PortmanteauDevices/Pianocade/board/Pianocade.sch

## KiCad design board/Pianocade.sch (2012-12-21)

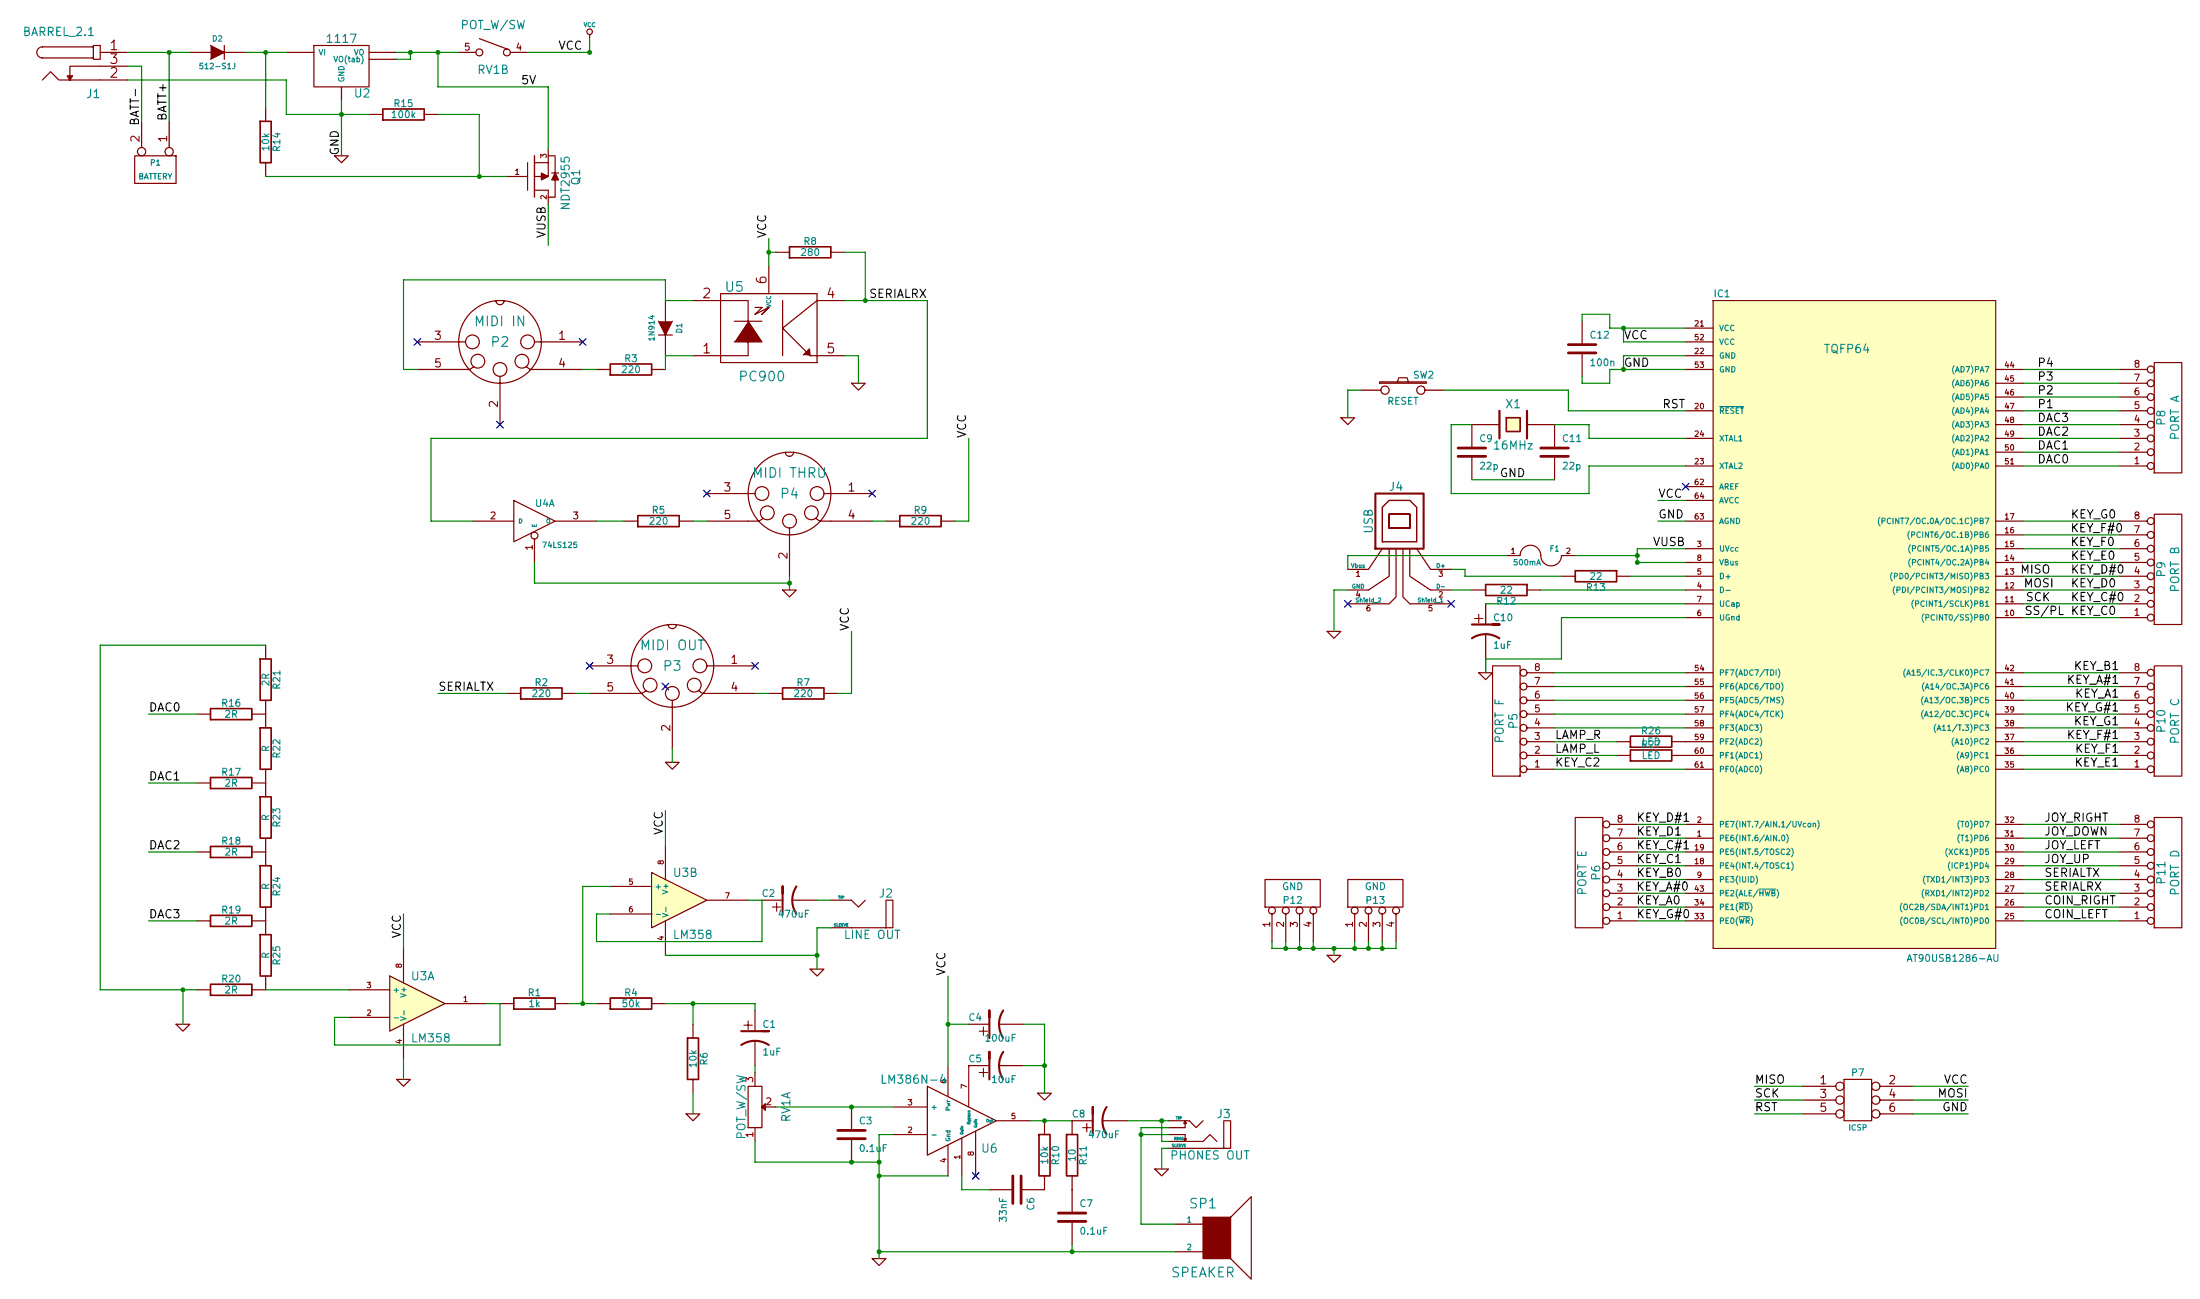
[picture p9: schematic Pianocade.sch]

Parts:
C1, C10: 1uF
C2, C8: 470uF
C3, C7: 0.1uF
C4: 100uF
C5: 10uF
C6: 33nF
C9, C11: 22p
C12: 100n
D1: 1N914
D2: 512-S1J
F1: 500mA; 1210; Part number MF-USMF050-2
IC1: AT90USB1286-AU; TQFP64
J1: BARREL_2.1
J2: LINE OUT
J3: PHONES OUT
J4: USB
P1: BATTERY
P2: MIDI IN
P3: MIDI OUT
P4: MIDI THRU
P5: PORT F
P6: PORT E
P7: ICSP
P8: PORT A
P9: PORT B
P10: PORT C
P11: PORT D
P12, P13: GND
Q1: NDT2955
R1: 1k
R2, R3, R5, R7, R9: 220
R4: 50k
R6, R10, R14: 10k
R8: 280
R11: 10
R12, R13: 22
R15: 100k
R16, R17, R18, R19, R20, R21: 2R
R22, R23, R24, R25: R
R26, R27: LED
RV1: POT_W/SW
SP1: SPEAKER
SW2: RESET
U2: 1117
U3: LM358
U4: 74LS125
U5: PC900
U6: LM386N-4
X1: 16MHz

Connections:
5V: Q1.3 (S), RV1.5, U2.2 (VO), U2.4 (VO(tab))
BATT+: D2.1 (A), J1.1 (CENTRE), P1.1
BATT-: J1.3 (SW), P1.2 (PM)
COIN_LEFT: IC1.25 ((OC0B/SCL/INT0)PD0), P11.1
COIN_RIGHT: IC1.26 ((OC2B/SDA/INT1)PD1), P11.2
DAC0: IC1.51 ((AD0)PA0), P8.1, R16.1
DAC1: IC1.50 ((AD1)PA1), P8.2, R17.1
DAC2: IC1.49 ((AD2)PA2), P8.3, R18.1
DAC3: IC1.48 ((AD3)PA3), P8.4, R19.1
GND: C3.2, C4.2, C5.2, C7.2, C9.2, C10.2, C11.2, C12.2, IC1.6 (UGnd), IC1.22 (GND), IC1.53 (GND), IC1.63 (AGND), J1.2, J2.1 (SLEEVE), J3.1 (SLEEVE), J4.4 (GND), P3.2, P4.2, P7.6, P12.1, P12.2, P12.3, P12.4, P13.1, P13.2, P13.3, P13.4, R6.2, R15.1, R20.1, R21.1, RV1.1, SP1.2, SW2.1, U2.1 (GND), U3.4 (V-), U4.1 (E), U5.5, U6.2 (-), U6.4 (Gnd)
JOY_DOWN: IC1.31 ((T1)PD6), P11.7
JOY_LEFT: IC1.30 ((XCK1)PD5), P11.6
JOY_RIGHT: IC1.32 ((T0)PD7), P11.8
JOY_UP: IC1.29 ((ICP1)PD4), P11.5
KEY_A0: IC1.34 (PE1(~RD~)), P6.2
KEY_A1: IC1.40 ((A13/OC.3B)PC5), P10.6
KEY_A#1: IC1.41 ((A14/OC.3A)PC6), P10.7
KEY_B0: IC1.9 (PE3(IUID)), P6.4
KEY_B1: IC1.42 ((A15/IC.3/CLK0)PC7), P10.8
KEY_C0: IC1.10 ((PCINT0/SS)PB0), P9.1
KEY_C1: IC1.18 (PE4(INT.4/TOSC1)), P6.5
KEY_C2: IC1.61 (PF0(ADC0)), P5.1
KEY_D0: IC1.12 ((PDI/PCINT3/MOSI)PB2), P7.4, P9.3
KEY_D1: IC1.1 (PE6(INT.6/AIN.0)), P6.7
KEY_E0: IC1.14 ((PCINT4/OC.2A)PB4), P9.5
KEY_E1: IC1.35 ((A8)PC0), P10.1
KEY_F0: IC1.15 ((PCINT5/OC.1A)PB5), P9.6
KEY_F1: IC1.36 ((A9)PC1), P10.2
KEY_F#1: IC1.37 ((A10)PC2), P10.3
KEY_G0: IC1.17 ((PCINT7/OC.0A/OC.1C)PB7), P9.8
KEY_G1: IC1.38 ((A11/T.3)PC3), P10.4
KEY_G#1: IC1.39 ((A12/OC.3C)PC4), P10.5
LAMP_L: P5.2, R27.1
LAMP_R: P5.3, R26.1
MISO: IC1.13 ((PD0/PCINT3/MISO)PB3), P7.1, P9.4
unnamed: C1.1, R4.2, R6.1
unnamed: C1.2, RV1.3
unnamed: C2.1, U3.6 (-), U3.7
unnamed: C2.2, J2.3 (TIP)
unnamed: C3.1, RV1.2, U6.3 (+)
unnamed: C5.1, U6.7 (Bypass)
unnamed: C6.1, R10.2
unnamed: C6.2, U6.1 (Gain)
unnamed: C7.1, R11.2
unnamed: C8.1, R10.1, R11.1, U6.5 (Out)
unnamed: C8.2, J3.2 (RING), J3.3 (TIP)
unnamed: C9.1, IC1.23 (XTAL2), X1.1
unnamed: C10.1, IC1.7 (UCap)
unnamed: C11.1, IC1.24 (XTAL1), X1.2
unnamed: D1.1 (A), P2.5, U5.2
unnamed: D1.2 (K), R3.2, U5.1
unnamed: D2.2 (K), R14.1, U2.3 (VI)
unnamed: F1.1, J4.1 (Vbus)
unnamed: IC1.2 (PE7(INT.7/AIN.1/UVcon)), P6.8
unnamed: IC1.4 (D-), R12.1
unnamed: IC1.5 (D+), R13.1
unnamed: IC1.16 ((PCINT6/OC.1B)PB6), P9.7
unnamed: IC1.19 (PE5(INT.5/TOSC2)), P6.6
unnamed: IC1.33 (PE0(~WR~)), P6.1
unnamed: IC1.43 (PE2(ALE/~HWB~)), P6.3
unnamed: IC1.54 (PF7(ADC7/TDI)), P5.8
unnamed: IC1.55 (PF6(ADC6/TDO)), P5.7
unnamed: IC1.56 (PF5(ADC5/TMS)), P5.6
unnamed: IC1.57 (PF4(ADC4/TCK)), P5.5
unnamed: IC1.58 (PF3(ADC3)), P5.4
unnamed: IC1.59 (PF2(ADC2)), R26.2
unnamed: IC1.60 (PF1(ADC1)), R27.2
unnamed: J3.5, J3.6, SP1.1
unnamed: J4.2 (D-), R12.2
unnamed: J4.3 (D+), R13.2
unnamed: P2.4, R3.1
unnamed: P3.4, R7.1
unnamed: P3.5, R2.2
unnamed: P4.4, R9.1
unnamed: P4.5, R5.2
unnamed: Q1.1 (G), R14.2, R15.2
unnamed: R1.1, U3.1, U3.2 (-)
unnamed: R1.2, R4.1, U3.5 (+)
unnamed: R5.1, U4.3 (O)
unnamed: R16.2, R21.2, R22.1
unnamed: R17.2, R22.2, R23.1
unnamed: R18.2, R23.2, R24.1
unnamed: R19.2, R24.2, R25.1
unnamed: R20.2, R25.2, U3.3 (+)
P1: IC1.47 ((AD4)PA4), P8.5
P2: IC1.46 ((AD5)PA5), P8.6
P3: IC1.45 ((AD6)PA6), P8.7
P4: IC1.44 ((AD7)PA7), P8.8
RST: IC1.20 (~RESET), P7.5, SW2.2
SCK: IC1.11 ((PCINT1/SCLK)PB1), P7.3, P9.2
SERIALRX: IC1.27 ((RXD1/INT2)PD2), P11.3, R8.2, U4.2 (D), U5.4
SERIALTX: IC1.28 ((TXD1/INT3)PD3), P11.4, R2.1
VCC: C4.1, C12.1, IC1.21 (VCC), IC1.52 (VCC), IC1.64 (AVCC), P7.2, R7.2, R8.1, R9.2, RV1.4, U3.8 (V+), U5.6 (VCC), U6.6 (Pwr)
VUSB: F1.2, IC1.3 (UVcc), IC1.8 (VBus), Q1.2 (D)
