PortmanteauDevices/Pianocade/pianocade_banked.h

  /* BANK 0, 50% square */
#define SQUARE50 {/* 0 */ 0x70, 0, /* 1 */ 0, 0, /* 2 */ 0, 0, /* 3 */ 0, 0, /* 4 */ 0, 0, /* 5 */ 0, 0, /* 6 */ 0, 0, /* 7 */ 0, 0, /* 8 */ 0, 0, /* 9 */ 0, 0, /* A */ 0, 0, /* B */ 0, 0, /* C */ 0, 0, /* D */ 0, 0, /* E */ 0, 0, /* F */ 0x30, 0}
  /* BANK 1, 25% square */
#define SQUARE25 {/* 0 */ 0x70, 0, /* 1 */ 0, 0, /* 2 */ 0, 0, /* 3 */ 0, 0, /* 4 */ 0, 0, /* 5 */ 0, 0, /* 6 */ 0, 0, /* 7 */ 0, 0, /* 8 */ 0, 0, /* 9 */ 0, 0, /* A */ 0, 0, /* B */ 0, 0, /* C */ 0, 0, /* D */ 0, 0, /* E */ 0, 0, /* F */ 0x30, 0}
  /* BANK 2, "Violin" */
#define VIOLIN {/* 0 */ 0x11, 0x03, /* 1 */ 0x70, 0, /* 2 */ 0x21, 0x03, /* 3 */ 0x72, 0, /* 4 */ 0, 0, /* 5 */ 0, 0, /* 6 */ 0, 0, /* 7 */ 0, 0, /* 8 */ 0, 0, /* 9 */ 0, 0, /* A */ 0, 0, /* B */ 0, 0, /* C */ 0, 0, /* D */ 0, 0, /* E */ 0, 0, /* F */ 0x30, 0}  
  /* BANK 3, 12.5% square */
#define SQUARE12{/* 0 */ 0x70, 0, /* 1 */ 0, 0, /* 2 */ 0, 0, /* 3 */ 0, 0, /* 4 */ 0, 0, /* 5 */ 0, 0, /* 6 */ 0, 0, /* 7 */ 0, 0, /* 8 */ 0, 0, /* 9 */ 0, 0, /* A */ 0, 0, /* B */ 0, 0, /* C */ 0, 0, /* D */ 0, 0, /* E */ 0, 0, /* F */ 0x30, 0}
  /* BANK 4, "Piano" */
#define PIANO{/* 0 */ 0x11, 0, /* 1 */ 0x70, 6, /* 2 */ 0x21, 0x02, /* 3 */ 0x72, 7, /* 4 */ 0x21, 0x0F, /* 5 */ 0x0F, 0x0F, /* 6 */ 0x74, 4, /* 7 */ 0, 0, /* 8 */ 0x77, 0, /* 9 */ 0, 0, /* A */ 0, 0, /* B */ 0, 0, /* C */ 0, 0, /* D */ 0, 0, /* E */ 0x21, 0, /* F */ 0x7E, 0}
 /* BANK 5, Tremolo (fast) */
#define TREMOLO_FAST{/* 0 */ 0x22, 0, /* 1 */ 0x70, 2, /* 2 */ 0x12, 0, /* 3 */ 0x72, 2, /* 4 */ 0x70, 0, /* 5 */ 0, 0, /* 6 */ 0, 0, /* 7 */ 0, 0, /* 8 */ 0, 0, /* 9 */ 0, 0, /* A */ 0, 0, /* B */ 0, 0, /* C */ 0, 0, /* D */ 0, 0, /* E */ 0, 0, /* F */ 0x30, 0}
 /* BANK 6, Mario coin (on release) */
#define COIN_RELEASE{/* 0 */ 0x70, 0, /* 1 */ 0x5C, 0, /* 2 */ 0x21, 0x02, /* 3 */ 0x72, 0, /* 4 */ 0, 0, /* 5 */ 0, 0, /* 6 */ 0, 0, /* 7 */ 0, 0, /* 8 */ 0, 0, /* 9 */ 0, 0, /* A */ 0, 0, /* B */ 0, 0, /* C */ 0, 0, /* D */ 0, 0, /* E */ 0, 0, /* F */ 0x30, 0}
  /* BANK 7, Game Boy envelope */
#define GB {/* 0 */ 0x21, 0x01, /* 1 */ 0x70, 0, /* 2 */ 0, 0, /* 3 */ 0, 0, /* 4 */ 0, 0, /* 5 */ 0, 0, /* 6 */ 0, 0, /* 7 */ 0, 0, /* 8 */ 0, 0, /* 9 */ 0, 0, /* A */ 0, 0, /* B */ 0, 0, /* C */ 0, 0, /* D */ 0, 0, /* E */ 0, 0, /* F */ 0x30, 0}
 /* BANK 8, Tremolo (slow) */
#define TREMOLO_SLOW {/* 0 */ 0x21, 0x1, /* 1 */ 0x70, 5, /* 2 */ 0x11, 0x1, /* 3 */ 0x72, 5, /* 4 */ 0x70, 0, /* 5 */ 0, 0, /* 6 */ 0, 0, /* 7 */ 0, 0, /* 8 */ 0, 0, /* 9 */ 0, 0, /* A */ 0, 0, /* B */ 0, 0, /* C */ 0, 0, /* D */ 0, 0, /* E */ 0, 0, /* F */ 0x30, 0}
  /* BANK 9, Echo on release */
#define ECHO {/* 0 */ 0x70, 0, /* 1 */ 0x21, 0x02, /* 2 */ 0x71, 5, /* 3 */ 0x13, 0, /* 4 */ 0x71, 4, /* 5 */ 0x30, 0, /* 6 */ 0, 0, /* 7 */ 0, 0, /* 8 */ 0, 0, /* 9 */ 0, 0, /* A */ 0, 0, /* B */ 0, 0, /* C */ 0, 0, /* D */ 0, 0, /* E */ 0, 0, /* F */ 0x30, 0}
 /* BANK A, Mario jump */
#define JUMP {/* 0 */ 0x57, 0x02, /* 1 */ 0x41, 0x04, /* 2 */ 0x3B, 0x01, /* 3 */ 0xA8, 0, /* 4 */ 0x21, 0, /* 5 */ 0x73, 0, /* 6 */ 0, 0, /* 7 */ 0, 0, /* 8 */ 0, 0, /* 9 */ 0, 0, /* A */ 0, 0, /* B */ 0, 0, /* C */ 0, 0, /* D */ 0, 0, /* E */ 0, 0, /* F */ 0x30, 0}
 /* BANK B, Mario coin */
#define COIN {/* 0 */ 0x05, 0, /* 1 */ 0x5C, 0, /* 2 */ 0x21, 0x02, /* 3 */ 0x72, 0, /* 4 */ 0, 0, /* 5 */ 0, 0, /* 6 */ 0, 0, /* 7 */ 0, 0, /* 8 */ 0, 0, /* 9 */ 0, 0, /* A */ 0, 0, /* B */ 0, 0, /* C */ 0, 0, /* D */ 0, 0, /* E */ 0, 0, /* F */ 0x30, 0}
  /* BANK C, Zelda get item */
#define ITEM {/* 0 */ 0, 0x01, /* 1 */ 0x21, 0, /* 2 */ 0xA9, 0x11, /* 3 */ 0, 0, /* 4 */ 0x71, 2, /* 5 */ 0x21, 0, /* 6 */ 0xA8, 0x11, /* 7 */ 0, 0, /* 8 */ 0x21, 0, /* 9 */ 0x74, 1, /* A */ 0xA9, 0x01, /* B */ 0x21, 0x01, /* C */ 0x7B, 10, /* D */ 0x21, 0, /* E */ 0x30, 0, /* F */ 0x30, 0}
  /* BANK D, Zelda magic rod */
#define MAGICROD {/* 0 */ 0, 0, /* 1 */ 0xA8, 0, /* 2 */ 0x71, 7, /* 3 */ 0x26, 0x5B, /* 4 */ 0xA8, 0, /* 5 */ 0x74, 2, /* 6 */ 0x13, 0x5B, /* 7 */ 0xA8, 0, /* 8 */ 0x77, 2, /* 9 */ 0x73, 1, /* A */ 0x30, 0, /* B */ 0, 0, /* C */ 0, 0, /* D */ 0, 0, /* E */ 0, 0, /* F */ 0x30, 0}
  /* BANK E, SMB stomp */
#define STOMP {/* 0 */ 0, 0, /* 1 */ 0xA8, 0x36, /* 2 */ 0xA8, 0x39, /* 3 */ 0xA9, 0x3C, /* 4 */ 0xA8, 0x3F, /* 5 */ 0x30, 0x01, /* 6 */ 0xAA, 0x33, /* 7 */ 0xA8, 0x37, /* 8 */ 0x00, 0x38, /* 9 */ 0xA9, 0x39, /* A */ 0xA8, 0x3C, /* B */ 0xA8, 0x3F, /* C */ 0x30, 0, /* D */ 0, 0, /* E */ 0, 0, /* F */ 0x30, 0}
