PortmanteauDevices/Pianocade/(commit log)

2012-01-14 Initial commit - functional port from Arduino code
    This set of files compiles to working code on the
    Teensy++ 2.0 board.
    makefile
    - Copied from MIDI project in LUFA
    pianocade.c
    pianocade.h
    - Adapted from Arduino project Pianocade.pde
    pianocade_banked.h
    - Not currently used, but contains instrument
    definition macros for future use
2012-01-14 Fix for shift issue (SMB jump noise)
    Fix for issue where a "runaway" pitch shift would
    cause an incorrect note, or no note, to be
    sounded. This happened on the SMB jump noise. The
    issue was caused by the pitch shift overflowing,
    thereby incorrectly setting the prescaler.
    The fix involves always resetting the pitch shift
    before setting the prescaler value.
    [pianocade.c]
2012-01-14 Allow "live" switching between sound patches
    One potential issue: if a sound goes to silence,
    but a note is held, then switching patches will
    make this note "come back." Hopefully the light
    of the hold button is enough to make this
    behaviour clear.
    [pianocade.c]
2012-01-15 Add LUFA libraries to project
    Some of these, I'm sure, can be deleted, but for
    now I'll just add all of them. None of these
    should ever need to be modified.
    [ConfiguringApps.txt]
2012-01-15 Implement variable velocity for MIDI note out
2012-01-26 Make MIDI receive processing more sophisticated
    MIDI was sometimes receiving a spurious NoteOn
    message (always a very low note, and received
    after holding down an arpeggio for a while --
    amount of hold time varied).
    The problem was partially addressed by verifying
    the MIDI packet CableNumber, but this just
    increased the average time before the problem
    occurred, implying that the CableNumber was random
    in the spurious message.
    By also validating the MIDI channel number
    (currently set at 0 via a #define), the problem
    seems to be solved (although it's possible that,
    just as checking cableNumber reduced the frequency
    of occurence, so too does checking the channel
    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
    [pianocade.c, pianocade.h]
2012-01-26 Improve mute method
    Muting stops oscillator 1. This prevents the very
    faint note sounding heard even when volume is set
    to 0.
    This treats the symptom, but doesn't get at the
    cause. Needs further investigation.
    [pianocade.c]
2012-03-31 Initial port to 0x00 prototype PCB
    This port is working to produce notes. The MIDI
    code is commented out, and while the bank-switch
    controls are working, the joystick (octave switch
    and pitch bend) aren't for unknown reasons.
2012-03-31 Fix for joystick
    The joystick wasn't working due to the JTAG Enable
    fuse being set; PORTF bits 4-7 are consumed by
    the JTAG interface, hence the non-responsiveness
    [pianocade.h]
2012-04-17 Updates for 0x00 migration: notes on fixes that need to be made for the 0x00 board, and changing the USB identifier text to reflect the board version
    [Descriptors.c]
2012-04-17 Improve interrupt routing by using ISR_NOBLOCK instead of having sei() right at the beginning. See http://www.nongnu.org/avr-libc/user-manual/group__avr__interrupts.html
2012-04-18 Add in code for Serial MIDI IN. Also, note apparent mis-wiring of MIDI IN jack on 0x00 schematic and PCB.
2012-04-21 Fix serial MIDI IN. Could use some cleanup, but noteOn and noteOff commands currently work.
    [Serial.c, Serial.h, pianocade.c]
2012-04-22 Moving MIDI message handling to separate file, containing both input and output over both Serial and USB. Also fixed some whitespace issues
    [MIDI.c, MIDI.h, pianocade.c, pianocade.h]
2012-04-22 Fixed whitespace and indentation problems
    [Descriptors.c, MIDI.c, MIDI.h, Serial.c, Serial.h, pianocade.c, pianocade.h]
2012-04-22 Replace hardcoded octave limit with #define
    [pianocade.c, pianocade.h]
2012-04-24 Changes to MIDI to comply with standards
    - Default velocity is 64
    - Add support for omni mode, on by default
    - As a result, move channel checking to
    individual methods
    - Add rudimentary Control Change support
2012-04-24 Filter out realtime MIDI messages
    Eventually, will (might) add support in the
    interrupt
2012-04-25 Add support for MIDI pitch wheel commands
2012-04-29 Add channel parameter to MIDI pitch bend messages
2012-04-29 Revamping arpeggiation system, adding chord toggle
    - Arpeggiation system now is more efficient, more
    readable, and works better with MIDI input
    - Added switch that toggles between sending out
    MIDI notes while arpeggiating and only sending out
    MIDI notes when pressed/released. Can act as a
    basis for local keyboard control
    KNOWN ISSUE: When the currently-sounding note in a
    chord is released, it continues sounding until
    the next tick of the arpeggio clock
    [MIDI.c, pianocade.c, pianocade.h]
2012-04-29 Immediately switch away from released chord note
    Fix for the known issue in the last commit (which
    also makes the code neater, to boot! Yay!)
    [pianocade.c]
2012-04-29 Rename current note/pitch to make more sense
    CURRENT_NOTE renamed to CURRENT_PITCH
    - This is used by the timers to generate the
    current sound, but is not necessarily the same as
    the note that was played, due to modifications by
    the current table
    MIDI_NOTE renamed to CURRENT_NOTE
    - This is the note that is currently requested,
    but it's not necessarily from MIDI, could also be
    local
2012-04-30 Added rudimentary incoming MIDI velocity support
2012-04-30 Fix for double noteOff on octave change
    [pianocade.c]
2012-05-09 Arp click removal and general code efficiency
    Get rid of the annoying audible "click" during
    fast arpeggiation. This was achieved by making the
    arp interrupt non-blocking. I tried that before
    without success, which turned out to be because
    the arp clock took too long. The solution was to
    change the arp interrupt speed. An even better
    solution would be to move the arp interrupt to the
    16-bit Timer3.
    Speaking of which, more efficiency could be found
    by setting the speed more intelligently on Timer0.
    [pianocade.c, pianocade.h]
2012-05-14 Process realtime MIDI clock messages
    If a realtime "start" or "continue" signal is sent
    switch off the internal arpeggiation timer and
    instead use the set MIDI clock tempo for advancing
    the arpeggiator. This allows syncing to external
    clock signals.
    A realtime "stop" command switches the flag back.
2012-06-14 Added support for coin buttons
    Currently doing octave shifts
2012-07-06 Fix for issue with changing patch on single notes
    [pianocade.c]
2012-07-06 Rewrote HOLD behaviour using both coin buttons
2012-07-07 Fix for bug caused by button mashing over chord
    If a chord was held and another button
    (or buttons) was pressed very rapidly, things
    would very quickly go nuts: weird sounds, global
    pitch shift, etc. All the symptoms of an overflow.
    If the NOBLOCK statement was removed from the arp
    interrupt, the problem would disappear, but the
    clicking during chords would return (see 332521b74969d1c9b80a99dba9c3a80a504cec11).
    The only thing that could cause an overflow seemed
    to be the chord length changing, which is only
    happening in one place, so I wrapped that in a
    cli()/sei() pair, and it appears to have done the
    trick.
    Also made chord_length volatile; not sure if that
    is actually necessary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
    [pianocade.c]
2012-07-17 More error handling in MIDI USB rx
    Not sure if this is actually helping or not,
    though
    [MIDI.c]
2012-07-17 Reset bend_step on new note
    [pianocade.c]
2012-07-17 Utility clock interrupt now blocks
    Doesn't seem to need non-blocking behaviour; may
    need to revisit
    [pianocade.c]
2012-07-17 Modulo on table array index to prevent overflows
    [pianocade.c]
2012-07-17 More fix for button mashing over chord
    Forgot to disable the interrupts around the other
    arp call; this may have been the problem to begin
    with. SEEMS fixed now, but might just be harder to
    reproduce
    [pianocade.c]
2012-07-18 Attempting to implement SysEx patch change on USB
    Currently, USB input doesn't seem to work at all
    [MIDI.c, MIDI.h, pianocade.c, pianocade.h]
2012-07-18 Fix for broken USB input
    Caused by extra & in commit b68fe7c447045f6bb702cefc232700338fe95dfe
    [MIDI.c]
2012-07-21 Reenabling USB-MIDI filtering
    Where the heck are these bad packets coming from?
    I need to get my hands on a hardware USB analyzer.
2012-07-21 Trigger new note whenever new button is pressed, and other minor changes
2012-07-22 Switch patch storage to EEPROM
2012-07-22 Add in pingpong arp mode, fix descending
    Descending arp mode MIDI commands were out of sync
    with the note being played.
    [pianocade.c, pianocade.h]
2012-07-23 Switch current_pitch to variable; remove shift=0's
2012-07-23 Switch current note to variable; remove shift=0's
    CURRENT_NOTE was a macro pointing to chord[arp_pos],
    but now it's a variable in anticipating of adding
    new ways of ordering arps (linked list for order
    pressed).
    There were lots of shift = 0 statements in places
    they didn't seem to make sense; now the only one is
    in the new_note() method
    [pianocade.c, pianocade.h]
2012-07-23 Add shift key and secondary funcs, arp speed fixes
    [pianocade.c, pianocade.h]
2012-12-21 Upgraded LUFA version
    [ConfiguringApps.txt]
2012-12-21 Add Kicad files
    [Pianocade.brd, Pianocade.sch]
2013-02-24 Add ability to boot into boot loader by holding down both coin buttons at power on
